DevilRulerEx/fyp-smart-thermometer/README.md

# Smart Non-Contact Thermometer with ESP32

This project is done in accordance to the fufillment of an Electrical Engineering bachelor degree. You may use the following citation to reference my work:

**Chng,  W. P. (2021). Smart non-contact thermometer with ESP32 and modular components. Final Year Project (FYP), Nanyang Technological University, Singapore. https://hdl.handle.net/10356/149139**

You may also reached me on my [LinkedIn](https://www.linkedin.com/in/wee-ping-chng-34841320b/).

## The project prototype

(Breif description)

(Pictures, Videos)

## Components used:
* ESP32 (LilyGo TTGO T-Display ESP32 CP2104) [Link to store page](https://sea.banggood.com/TTGO-T-Display-ESP32-CP2104-WiFi-bluetooth-Module-1_14-Inch-LCD-Development-Board-LILYGO-for-Arduino-products-that-work-with-official-Arduin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)
* GM65 Barcode Scanner
* MLX90614 Temperature Sensor

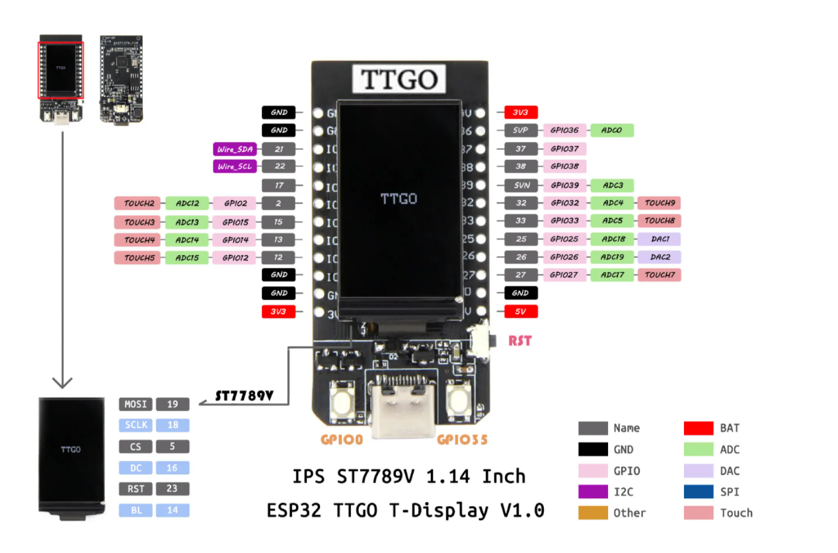
[picture p1: Component Information/LilyGo TTGO T-Display ESP32/LilyGo TTGO Pin Diagram.png]
LilyGo TTGO Pin Diagram

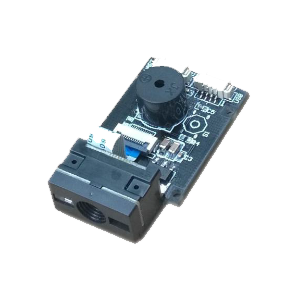
[picture p2: Component Information/MG65 Barcode Scanner/pic03.png]

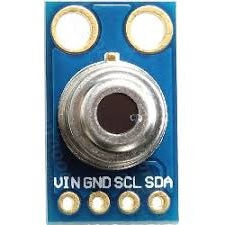
[picture p3: Component Information/MLX90614 Temperature Sensor/pic01.jpg]


## Software used:
* Arduino IDE
* XAMPP
* PhpMyAdmin

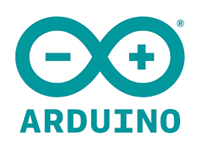
[picture p4: Misc Images/arduino.png]

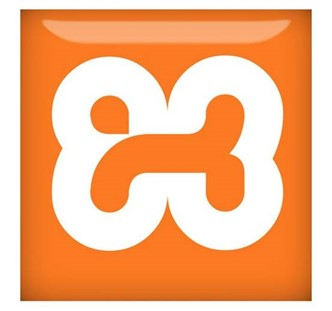
[picture p5: Misc Images/xamp.jpg]


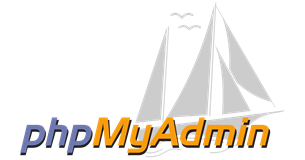
[picture p6: Misc Images/phpmyadmin.png]


## Setting up the project
If you are already experienced in Arduino project (and I recommend starting with Arduinos projects first before delving into ESP32), programming an ESP32 can be familiar with you, but some setup are required in the Arduino IDE before you can program. Follow the steps in this page to setup the Arduino IDE [(Installing ESP32 in Arduino IDE)](https://randomnerdtutorials.com/installing-the-esp32-board-in-arduino-ide-windows-instructions/)

For data collection purposes, I used XAMPP to create a local host server to store all the temperature records. Of course you could use your own web servers.

If you are using the same componenets as I did, include the following libraries in Arduino IDE. Under Tools, set the board to be "TTGO LoRa32-OLED V1".

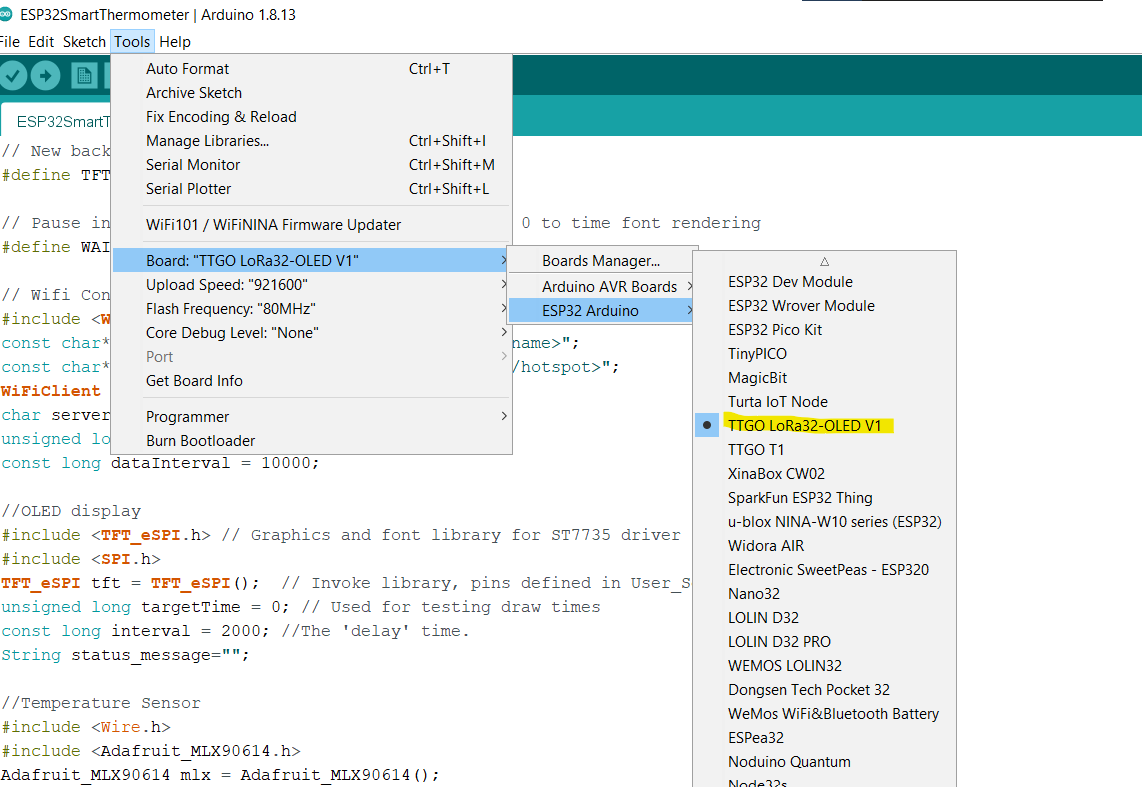
[picture p7: Misc Images/boardmanager.png]

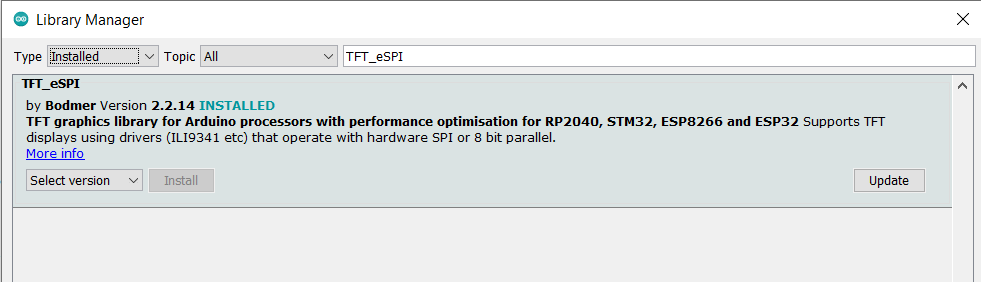
[picture p8: Misc Images/tft_espi.png]

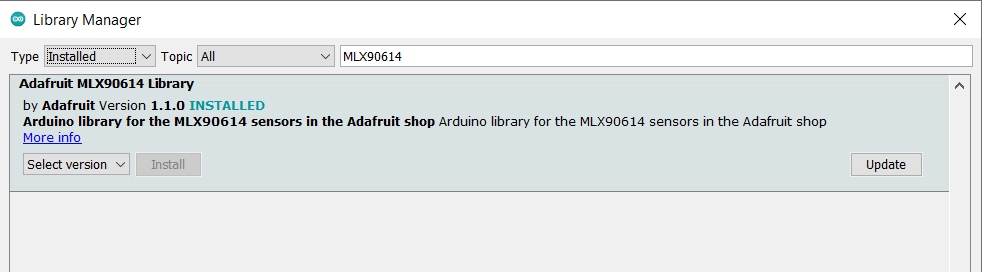
[picture p9: Misc Images/mlxlibrary.png]


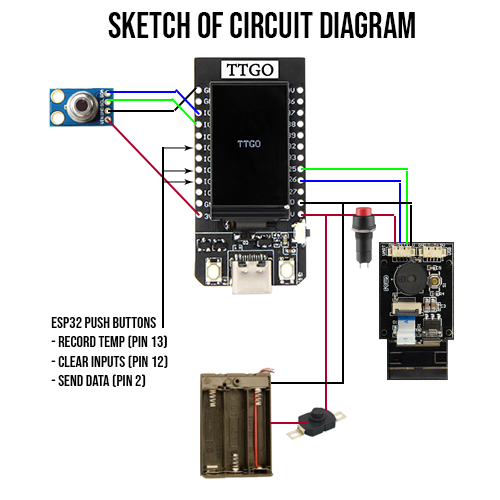
[picture p10: Project Information/Circuit Diagram Sketch 2.png]
