DevilRulerEx/fyp-smart-thermometer/Project Information/Gantt Chart v2.pdf

| | 8/20 9/20 10/20 11/20 12/20 1/21 2/21 3/21 4/21 5/21
19 23 | 30 | 6 | 13 | 20 | 27 | 4 | 11 | 18 | 25 | 1 | 8 | 15 | 22 | 29 | 6 | 13 | 20 | 27 | 3 | 10 | 17 | 24 | 31 | 7 | 14 | 21 | 28 | 7 | 14 | 21 | 28 | 4 | 11 | 18 | 25 | 2 | 9 | 16
Final Year Project | start | end
First Semester | 20/08/20 | 02/10/20
Source Planned Materials | 20/08 | 04/09
Practice Arduino | 07/09 | 02/10
First Semester After Recess Week | 05/10/20 | 09/11/20
Experiment IR Sensor data extraction | 05/10 | 09/10
Experiment bar-code scanner data e... | 12/10 | 16/10
Experiment Wi-Fi connection | 19/10 | 23/10
Building a prototype | 26/10 | 06/11
Interim Report Deadline | 09/11 | 09/11
Winter Break | 07/12/20 | 08/01/21
Building the improved prototype | 07/12 | 18/12
Implement Wi-Fi Connection | 21/12 | 25/12
myPhpAdmin [Learn and implement] | 28/12 | 08/01
Achieve Minimum Viable Product | 08/01 | 08/01
Second Semester | 11/01/21 | 05/03/21
3D Print [Learn and implement] (Nice... | 11/01 | 12/02
Assembling the Project for Final Demo | 12/02 | 05/03
Second Semester After Recess We... | 08/03/21 | 19/05/21
Final preparation before submission | 08/03 | 09/04
Final Report | 09/04 | 09/04
Project Demonstration Week | 12/04 | 12/04
Oral Presentation | 10/05 | 10/05
Final Report (After Oral Presentation)... | 19/05 | 19/05

Powered by TCPDF (www.tcpdf.org)
