DevilRulerEx/fyp-smart-thermometer/Misc Images/xampconfig2.png

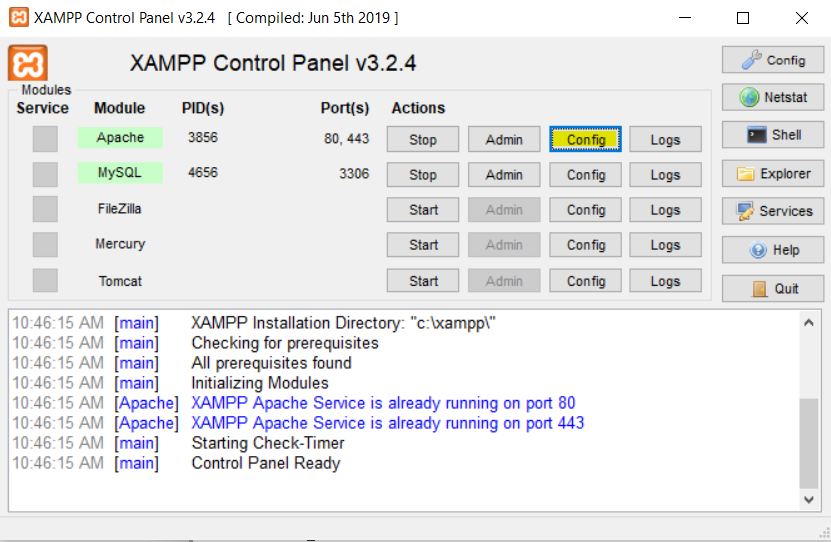
Misc Images/xampconfig2.png
