DevilRulerEx/fyp-smart-thermometer/Misc Images/xampconfig.png

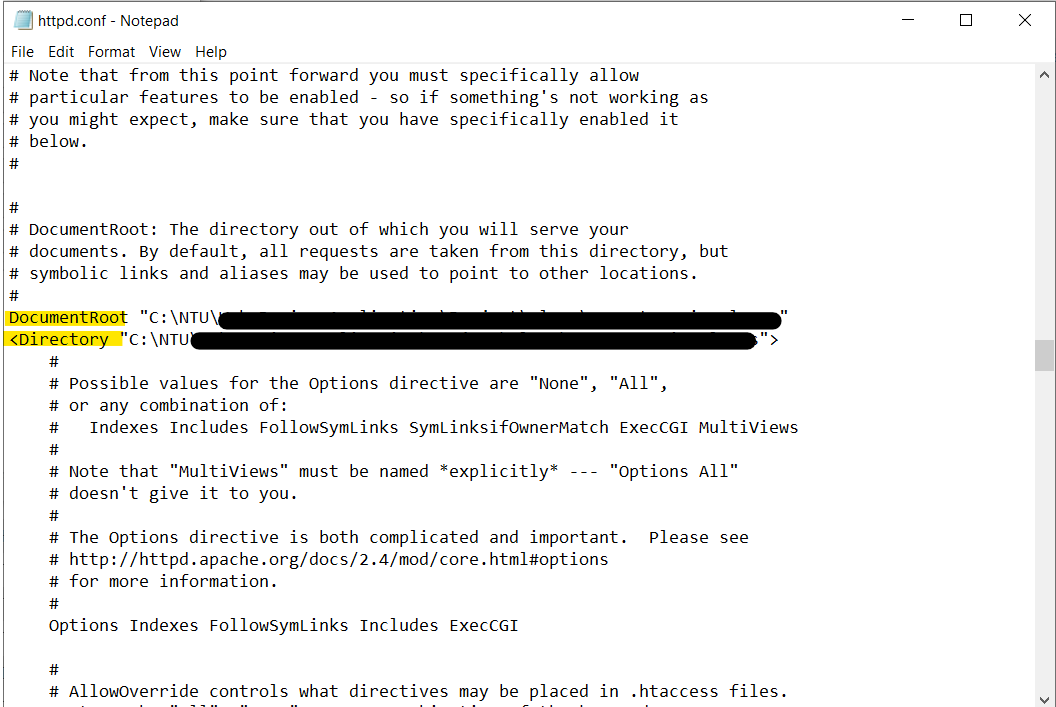
Misc Images/xampconfig.png
