DevilRulerEx/fyp-smart-thermometer/Project Information/Circuit Diagram Sketch.png

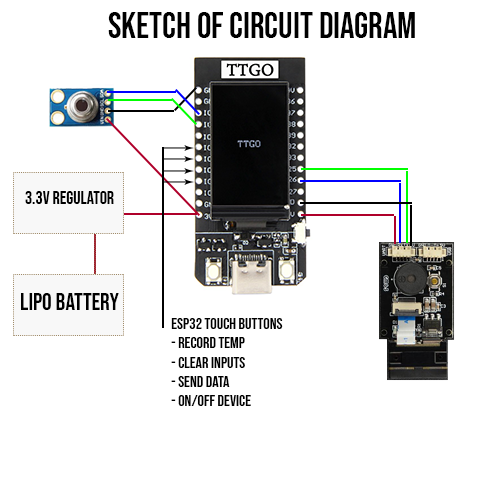
Project Information/Circuit Diagram Sketch.png
