DevilRulerEx/fyp-smart-thermometer/Project Information/Gantt Chart.png

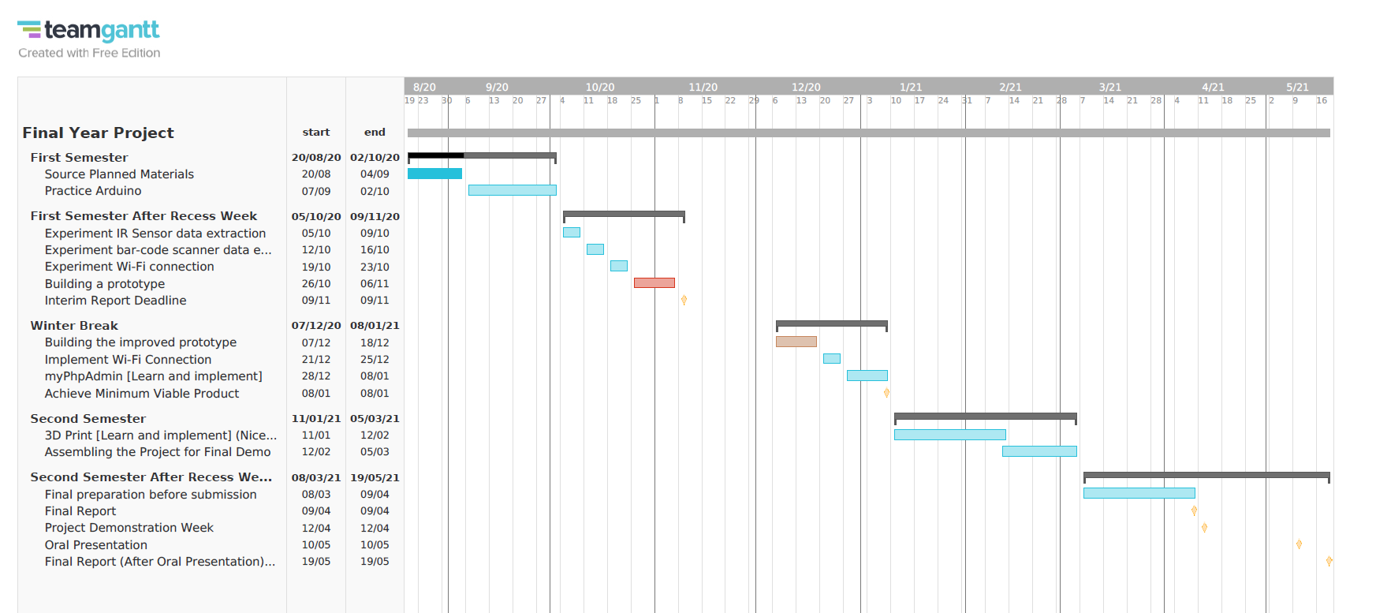
Project Information/Gantt Chart.png
