DevilRulerEx/fyp-smart-thermometer/Project Information/Layout Sketch.png

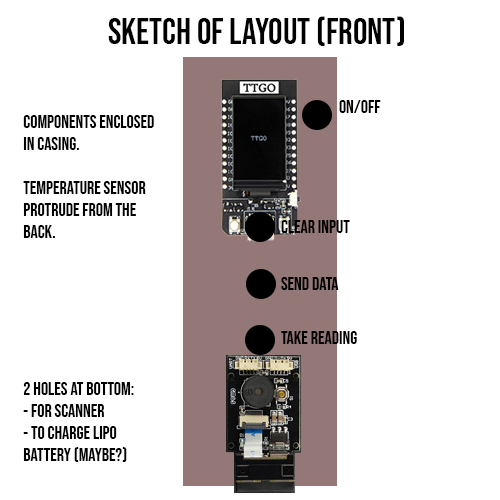
Project Information/Layout Sketch.png
