DevilRulerEx/fyp-smart-thermometer/Project Information/Prototype01.PNG

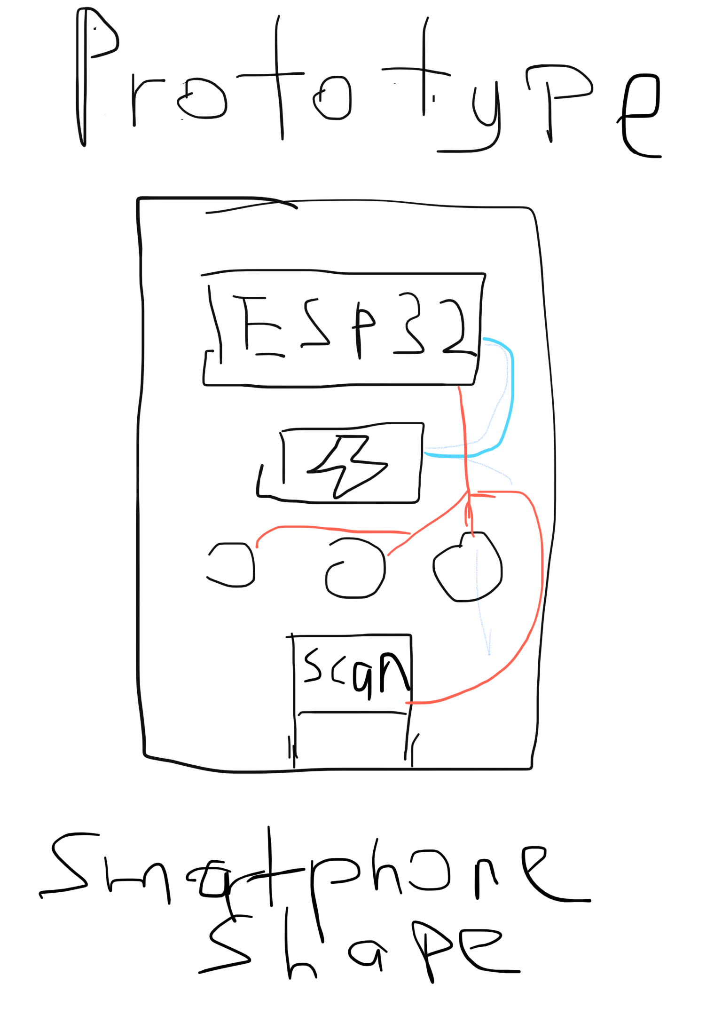
Project Information/Prototype01.PNG
