DevilRulerEx/fyp-smart-thermometer/Project Information/StoryBoard.png

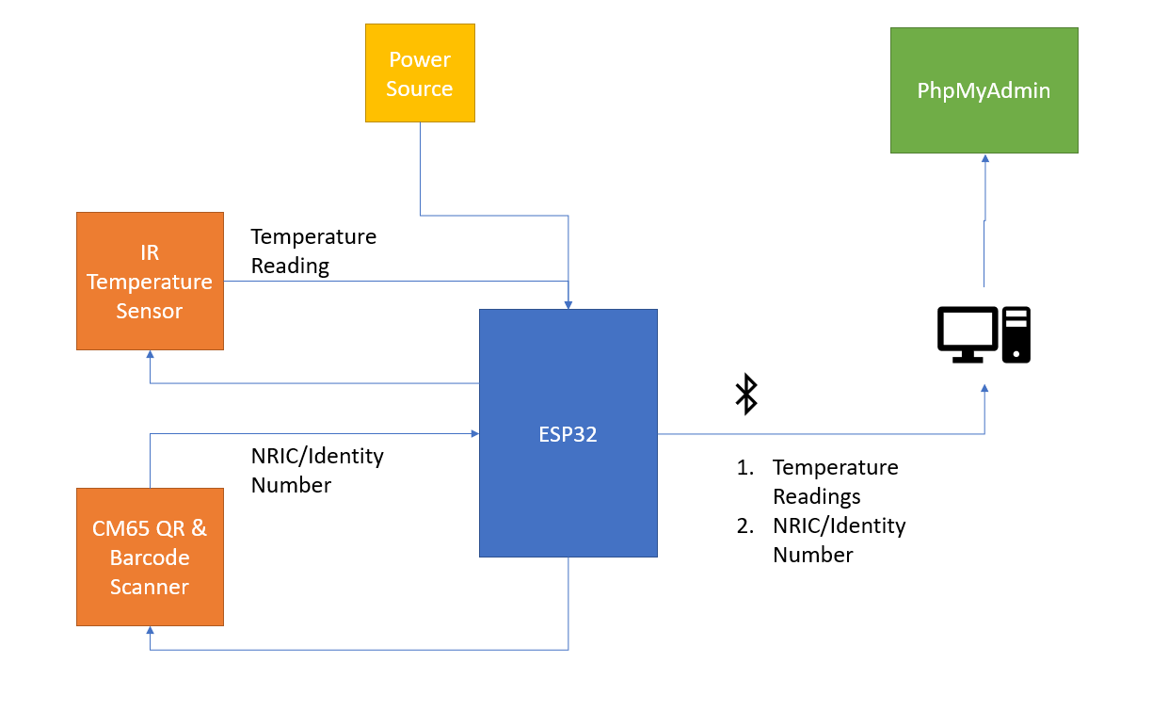
Project Information/StoryBoard.png
