DevilRulerEx/fyp-smart-thermometer/Showcase/First Iteration (Display, Temp)/IMG_1729.jpeg

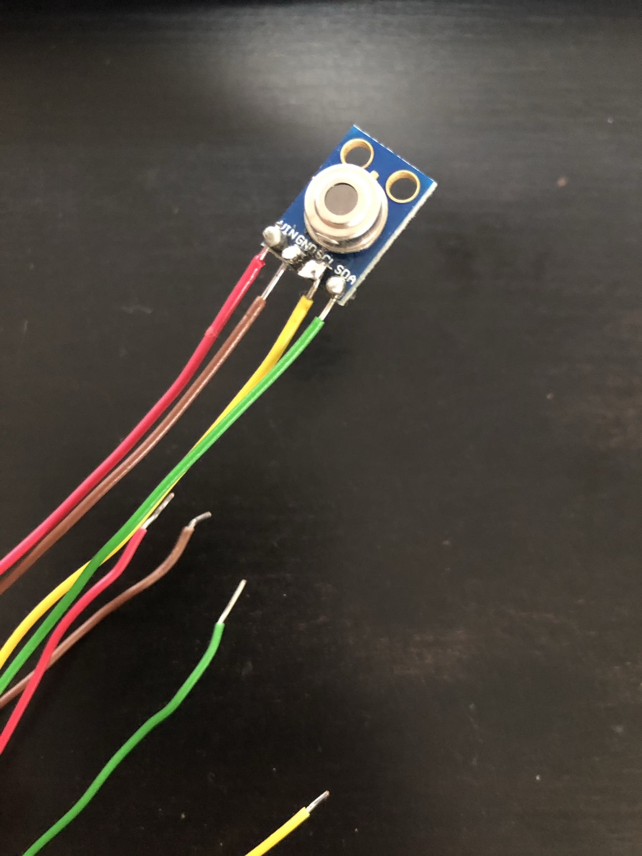
Showcase/First Iteration (Display, Temp)/IMG_1729.jpeg
