DevilRulerEx/fyp-smart-thermometer/Showcase/Prototype/IMG_2011.JPEG

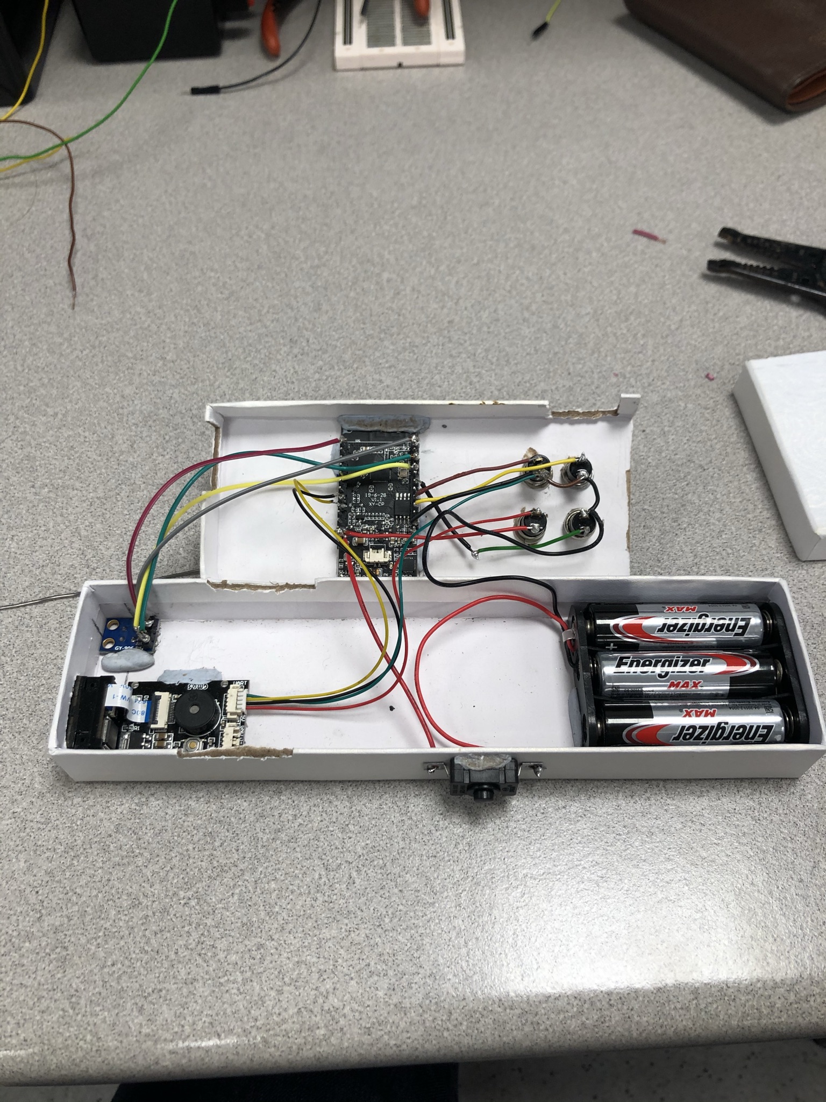
Showcase/Prototype/IMG_2011.JPEG
