DevilRulerEx/fyp-smart-thermometer/Showcase/Prototype/IMG_2012.JPEG

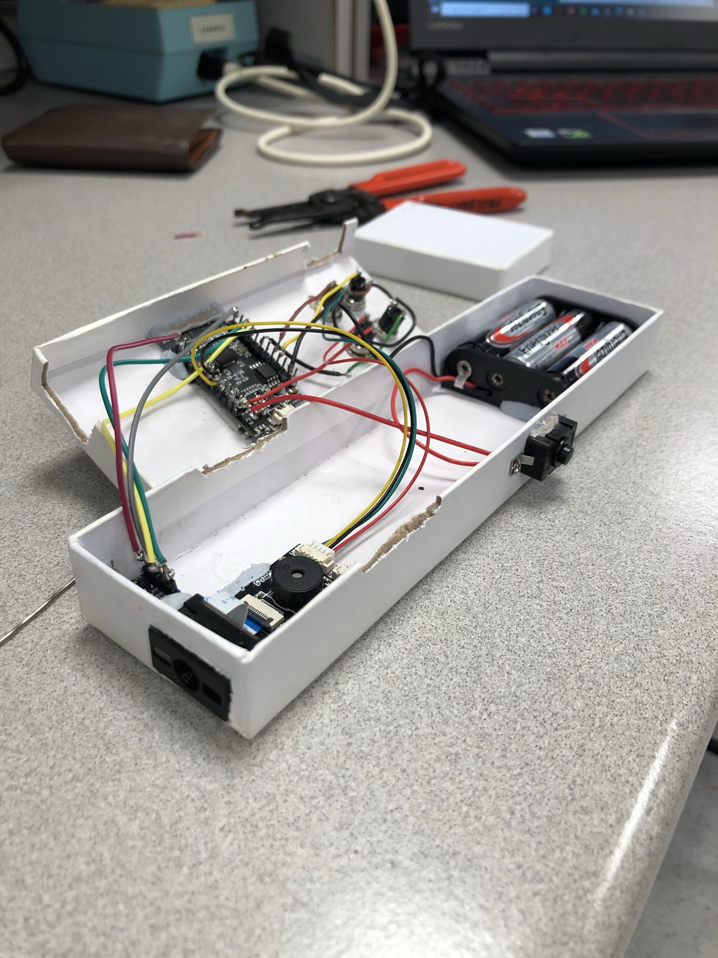
Showcase/Prototype/IMG_2012.JPEG
