DevilRulerEx/fyp-smart-thermometer/Showcase/Prototype/IMG_2013.JPEG

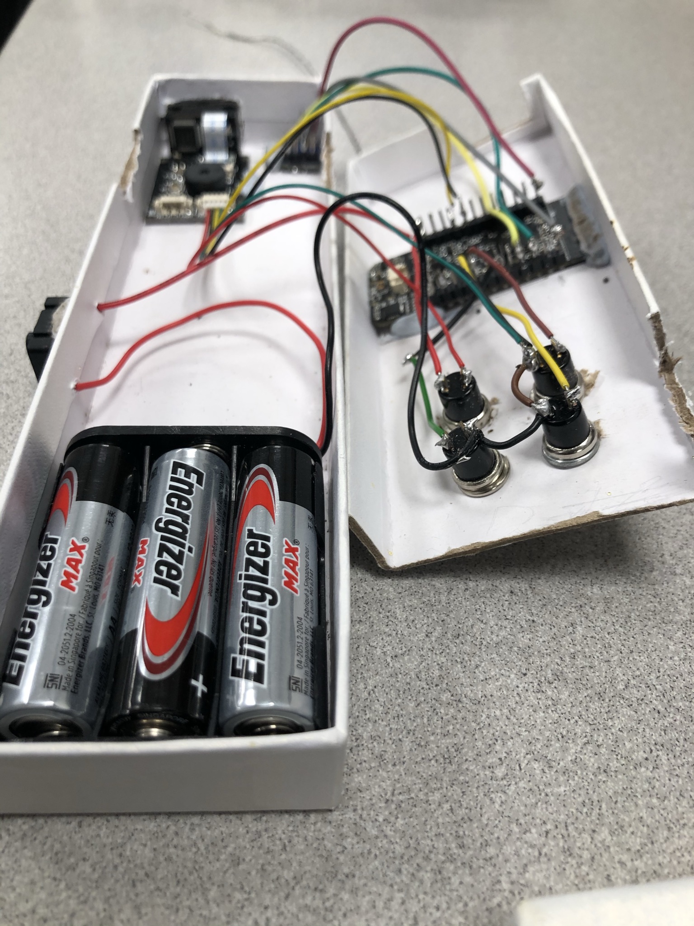
Showcase/Prototype/IMG_2013.JPEG
