DevilRulerEx/fyp-smart-thermometer/Showcase/Prototype/IMG_2014.JPEG

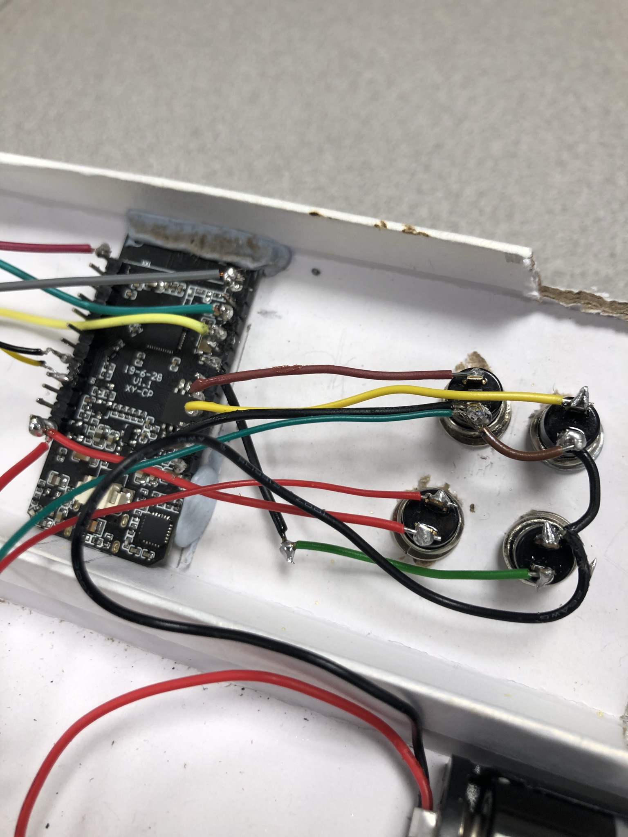
Showcase/Prototype/IMG_2014.JPEG
