DevilRulerEx/fyp-smart-thermometer/Showcase/Prototype/IMG_2019.JPEG

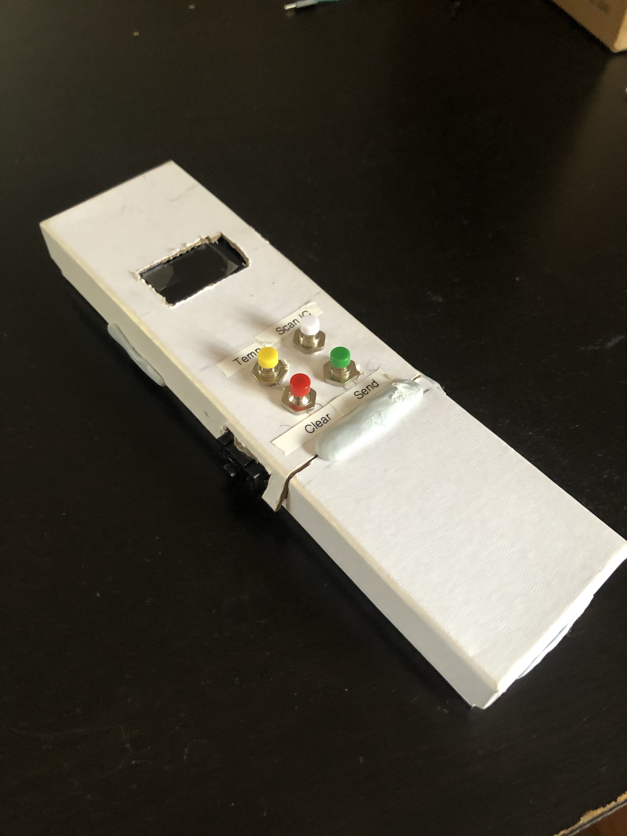
Showcase/Prototype/IMG_2019.JPEG
