DevilRulerEx/fyp-smart-thermometer/Showcase/Prototype/IMG_2027.JPEG

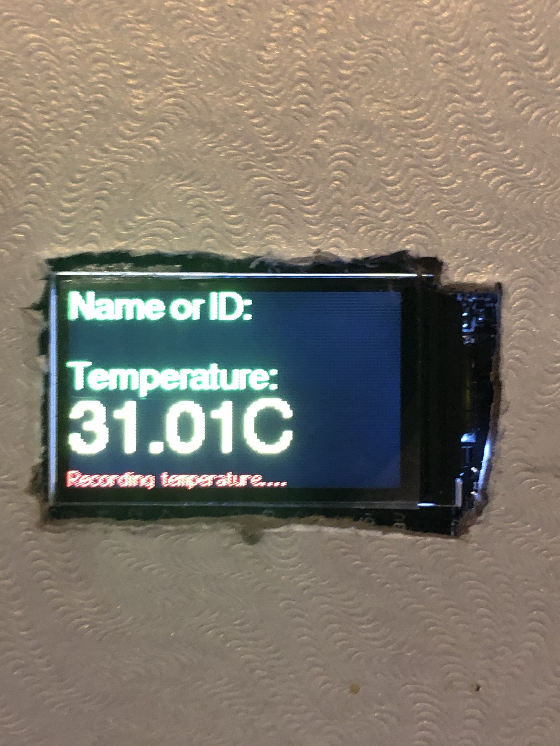
Showcase/Prototype/IMG_2027.JPEG
