DevilRulerEx/fyp-smart-thermometer/Showcase/Second Iteration (Display, Temp, Scanner)/ss00.png

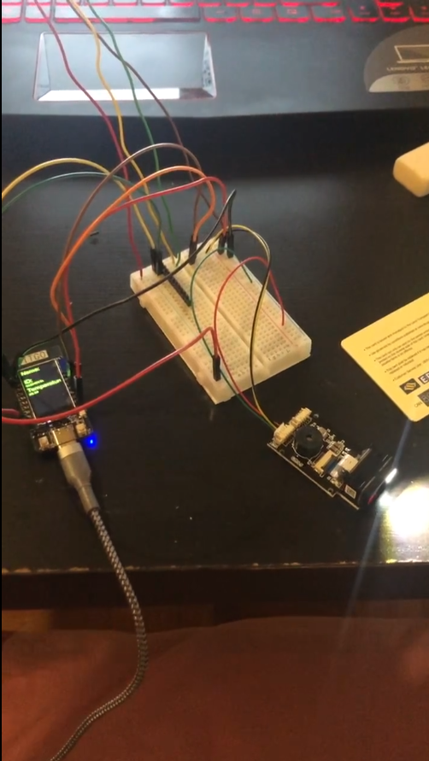
Showcase/Second Iteration (Display, Temp, Scanner)/ss00.png
