DevilRulerEx/fyp-smart-thermometer/Component Information/LilyGo TTGO T-Display ESP32/Links.txt

http://www.lilygo.cn/prod_view.aspx?TypeId=50033&Id=1126&FId=t3:50033:3

https://github.com/Xinyuan-LilyGO/TTGO-T-Display
