DevilRulerEx/fyp-smart-thermometer/Component Information/LilyGo TTGO T-Display ESP32/pic00 transparent.png

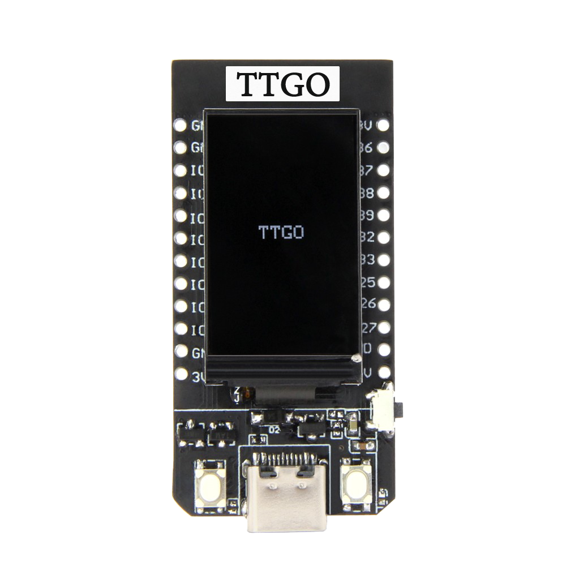
Component Information/LilyGo TTGO T-Display ESP32/pic00 transparent.png
