DevilRulerEx/fyp-smart-thermometer/Component Information/MG65 Barcode Scanner/pic02.jpg

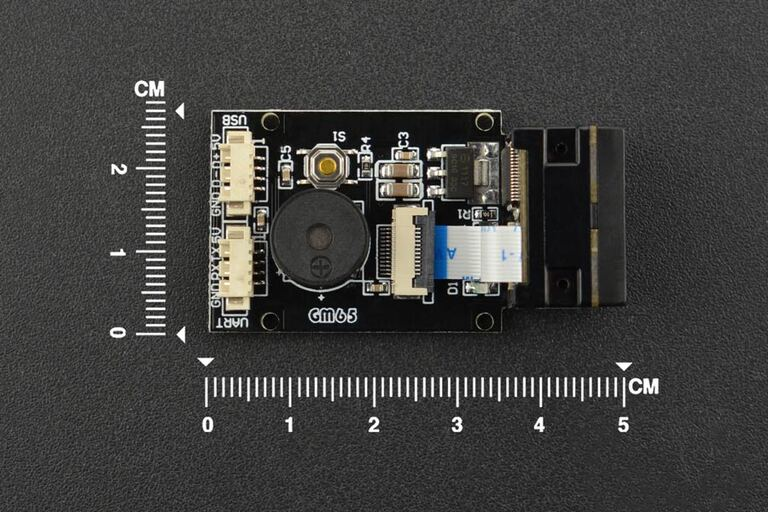
Component Information/MG65 Barcode Scanner/pic02.jpg
