DevilRulerEx/fyp-smart-thermometer/(commit log)

2021-03-26 Prototype Version
2021-06-03 Replace temp sensor image
